rabbits-robotics/rabbits_description/README.md

# rabbits_description



機体の URDF（xacro）と rviz での表示 launch。`urdf/<機体>/` と `meshes/<機体>/` に機体ごとに置き、機体をまたいで使うもの（色の定義など）だけ `urdf/common/` に置く。

| 機体 | 最上位 | 内容 |
|---|---|---|
| proto1 | `urdf/proto1/proto1.xacro` | オムニ 4 輪 + 砲塔 Yaw / Pitch（メッシュあり） |
| gamma | `urdf/gamma/gamma.xacro` | 脚 4 本（4 節リンク、各脚の先に車輪）+ 首 Yaw / Pitch / Roll + カメラ。**脚は実寸**（`config/gamma_linkage.yaml`）、**首と胴体は仮**（箱と円筒）。メッシュは下の約束で書き出したら差し替える |

```bash
ros2 launch rabbits_description display.launch.py robot:=gamma use_gui:=true   # スライダで関節を動かして確認
ros2 launch rabbits_description display.launch.py robot:=gamma                # joint_states は外（robot_bridge など）から
```

```
urdf/
  common/materials.xacro     色の定義
  proto1/proto1.xacro        最上位 + 部品マクロ（mobile_base, wheel, turret_base, turret_unit）
  gamma/gamma.xacro          最上位 + 部品マクロ（body, leg, neck）
config/gamma_linkage.yaml    gamma の脚リンクと首の寸法（xacro とノードが読む。gamma_turret_fw の robot.hpp と対で更新）
include/rabbits_description/linkage_params.hpp  gamma_linkage.yaml を ROS パラメータから読むライブラリ（下の「ライブラリ」）
include/rabbits_description/footprint.hpp        4 輪の接地点と胴体の置き方（base_footprint → base_link）の計算（同上）
src/linkage_state_publisher.cpp  gamma の派生関節を足すミキサー（motor_joint_states → joint_states）
meshes/
  proto1/*.dae
  gamma/                     メッシュを書き出したら
rviz/display.rviz
```

## ライブラリ `rabbits_description::rabbits_description`

ミキサーのほか rabbits_sim（偽ファーム）と rabbits_gui（`imu_footprint_node`）が使う共通部分。yaml の読み方と接地点の計算を 1 か所にまとめる。

**`linkage_params.hpp`**: `config/gamma_linkage.yaml` の `linkage.*` を ROS パラメータから rabcl の設定構造体に読む関数。

| 関数 | 読むパラメータ | 返す型 |
|---|---|---|
| `LoadLegLinkage(node)` | `linkage.crank_length` 〜 `theta_max`（脚リンクの寸法） | `rabcl::LegLinkageConfig` |
| `LoadBodyPosture(node)` | 上 + `drop_min` / `drop_max` / `tilt_radius` / `leg_azimuth` | `rabcl::BodyPostureConfig` |
| `LoadFootprintParams(node)` | `leg_radius` / `wheel_radius` / `leg_azimuth` | `FootprintParams` |

すべて必須。足りない・型が違う・要素数が違うと `std::invalid_argument`（`what()` にパラメータ名）。未宣言なら `declare_parameter` し、宣言済みなら読むだけなので、同じノードで複数の `Load*` を呼べる。

**`footprint.hpp`**: 4 輪の接地点（base 座標）と、それを地面 z = 0 に乗せる `base_footprint → base_link` の回転と高さ。`ContactPointsOf(pose[4], FootprintParams)` が接地点（車輪中心の真下 `wheel_radius`）、`PlaneFootprint(c, quat, height)` が 4 輪が同じ平面に接地するとしたときの姿勢（対角線 2 本の外積で法線、4 点の平均で高さ。yaw なし）、`LowestWheelHeight(c, quat)` が与えた姿勢で最も低い接地点が地面に乗る高さ（IMU の姿勢と組み合わせて使う）。

使う側は `package.xml` に `<depend>rabbits_description</depend>`、CMake で `find_package(rabbits_description REQUIRED)` と `target_link_libraries(x rabbits_description::rabbits_description)`。

## gamma

- 関節名は [rabbits_bridge](https://github.com/rabbits-robotics/rabbits_bridge) の `config/gamma.yaml` の `joints`（関節番号順）と同じ: `yaw_joint`, `pitch_joint`, `roll_joint`, `right_front_wheel_joint`, `left_front_wheel_joint`, `right_back_wheel_joint`, `left_back_wheel_joint`, `right_front_leg_joint`, `left_front_leg_joint`, `right_back_leg_joint`, `left_back_leg_joint`。ファームの `JOINT_STATE` → bridge の `joint_states` がそのまま入る。
- 軸の向き（確定。設計書は rabbits_sim の `docs/superpowers/specs/2026-10-24-gamma-sim-design.md` 5 章）: 車輪は車輪リンクの z 軸が回転軸で z 正が機体の外側。脚は角度 0 が最下点（メカスト、原点）で、角度が増えると腕の先の車輪が下がり車体が上がる。首は yaw（z）→ pitch（y、−π/12〜π/6）→ roll（x、±π/6）→ `camera_link`（カメラ）→ `imu_link`（固定、BNO055。bridge の `imu/data` の `frame_id`）。符号は REP-103。
- `imu_link` の向きは `camera_link` と同じ（回転なし）。軸の入れ替えはファームが BNO055 のレジスタで済ませて `imu/data` をカメラ座標系で出すので、TF で二重に回さない。位置は仮（カメラの後ろ 0.03 m）。
- 脚は 4 節リンク（モータ軸 → クランク → 連結リンク → 車輪ホルダ、ホルダを平行に保つバー 2 本。記号と形は [docs/gamma_leg_linkage.svg](docs/gamma_leg_linkage.svg)、設計書は rabcl の `docs/superpowers/specs/2026-10-25-gamma-leg-linkage-design.md`）。URDF は木構造なのでループを連結リンクの先端で切り、各脚に `*_leg_joint`（モータ角、`joint_states`）、`*_bar_joint` と `*_coupler_joint`（派生）、`*_bar_lower_joint` と `*_holder_joint`（`mimic`）、`*_wheel_joint` を置く。派生関節は線形でないので `mimic` では表せず、**`linkage_state_publisher`（ミキサー）** が `motor_joint_states`（bridge / 偽ファームの出力をリマップしたもの）を受け、そのまま写したうえで派生 8 関節を rabcl `LegLinkage` で計算して足し、`joint_states` を 1 本で出す。`/joint_states` の発行元はこのノードだけ（1 トピック 1 発行元）。ミキサーが落ちると `robot_state_publisher` に何も届かない。入力に無い首関節（`fill_zero_joints`、既定 `yaw_joint` / `pitch_joint` / `roll_joint`）は 0 で埋めて出す。首のモータが未接続でも `imu_link` / `camera_link` までの TF の鎖が切れないようにするため。
- リンクのフレームは「z = その関節の回転軸、x = ゼロ姿勢でのリンクの長さ方向」（メッシュの座標系と同じ）。関節の値はゼロ姿勢からの変化分で、正 = 車体が上がる向き（ゼロ姿勢では全関節 0）。ミキサーが出す値は bar = −(φ − φ0)、coupler = −((ψ − α) − (ψ0 − α0))。
- base 原点は 4 本の脚モータ軸を含む水平面と Yaw 軸の交点（x 前、y 左、z 上）。首 Yaw 原点はその 25.5 mm 下、Pitch / Roll はそこから 126.4 mm 上の同じ点（仮）。
- pitch / roll は論理関節（ファームが差動リンクの 2 モータ角から求めた値）。ロール軸を後回しにする間は 0 が来て静止する。
- ミキサーは `base_footprint → base_link` の TF も出す（`publish_footprint`、既定 true）。4 輪の接地点（車輪中心の真下 `wheel_radius`。脚の方位角は yaml の `linkage.leg_azimuth`）が地面 z = 0 に乗るように、対角線 2 本の外積で地面の法線、4 点の平均で高さを決める。yaw は含めない（`base_footprint` の x は胴体の前を地面に投影した向き）。rviz の固定フレームは `base_footprint`（display.rviz / bringup の gamma.rviz）なので、車高を上げると胴体が上がり、ロール・ピッチで胴体が傾いて見える。オドメトリ（`map → base_footprint`）は無い。
- 車輪の回転の向きは、`joint_states` に入る角度（ファーム / 偽ファームの `OmniDrive × WHEEL_SIGN`）をそのまま表す。現状の `WHEEL_SIGN = -1` では前進指令で後ろに転がって見える（rabbits_sim の README「rviz での車輪の向きの読み方」）。

### gamma のメッシュの座標系（CAD で STL を書き出すときの約束）

STL はリンクごとに 1 ファイル（`meshes/gamma/<リンク>.stl`、バイナリ、mm、粗い解像度で 1 ファイル 1〜2 MB 以下）。**各 STL の原点と軸は、そのリンクの URDF フレームに一致させる**（xacro 側の visual origin を 0 にしておくため）。すべて右手系、ゼロ姿勢（脚はモータ原点 = 最下点、首はまっすぐ前）で書き出す。同じ形の脚と車輪は右前の 1 組だけ書き出し、4 本に使い回す。大きすぎる STL は Blender の Decimate（collapse）で減らす（胴体は 155k → 46k 三角形、比率 0.3 で見た目を保てた。`blender -b --python <script>` で `wm.stl_import` → Decimate → `wm.stl_export`、軸変換なし）。

| STL | 中身 | 原点 | 軸（= URDF のリンクフレーム） |
|---|---|---|---|
| `base.stl` | 胴体と胴体に固定の部品（脚モータの固定側、バーの胴体側ブラケットを含む） | base 原点（4 本の脚モータ軸を含む水平面と Yaw 軸の交点） | x 前、y 左、z 上 |
| `crank.stl` | 右前のクランク（脚モータの出力ディスクに付いて回る板） | 脚モータ軸 M 上、横方向は脚の中心面 | z = モータの回転軸（右ねじで回すと先端が下がる向き）、x = M → 先端ピン K の向き |
| `coupler.stl` | 右前の連結リンク（L 字） | クランク先端ピン K 上、横方向は脚の中心面 | z = ピンの軸（同じ向き）、x = K → ホルダ上端ピン J の向き |
| `bar.stl` | 右前の上側のバー、左右 2 本をまとめて 1 ファイル（下側も同じ形なら使い回す） | 胴体側ピン B1 上、横方向は脚の中心面 | z = ピンの軸（同じ向き）、x = B1 → H1 の向き |
| `holder.stl` | 右前の車輪ホルダ（車輪モータの固定側、ギア列、ピン類を含む） | 上のバーのホルダ側ピン H1 上、横方向は脚の中心面 | z = ピンの軸（同じ向き）、x = 水平で半径方向の外向き（y は下） |
| `wheel.stl` | 右前の車輪 1 個 | 車輪の中心 W | z = 回転軸で z 正が機体の外側、x = 上 |
| `neck_yaw.stl` | Yaw 軸で回る部品 | Yaw 軸上の 1 点（base 原点の 25.5 mm 下 = `yaw_origin_z`） | x 前、y 左、z 上 |
| `neck_pitch.stl` | Pitch 軸で回る部品（あれば） | Pitch / Roll 軸の交点（Yaw 原点の 126.4 mm 上） | 同上 |
| `neck_camera.stl` | Roll 軸より先（カメラ、gamma_turret 基板）（あれば） | 同じ点 | 同上 |

部品ごとの原点と軸の図: [docs/gamma_mesh_origins.svg](docs/gamma_mesh_origins.svg)。脚の部品は「z = 取り付け側の関節の回転軸、x = ゼロ姿勢での長さ方向」で、CAD の部品座標系をそのまま使える。z の向きは 4 つのピン軸で共通（脚の面の y_left。側面図で見ると紙面の奥）。原点の横方向（y_left 方向）は部品の厚みの中央ではなく**脚の中心面**（車輪の中心を通り、クランクとバーが動く面）に取る。部品が中心面から横にずれて付いているなら、そのずれが STL にそのまま写るのが正しい。同じ形の脚と車輪は右前の 1 組だけ書き出し、4 本に使い回す。

あわせて控える値（mm / deg、各リンクの原点からの相対）:

| 値 | 使う先 |
|---|---|
| 脚の取り付け半径 r（`base` 原点から脚の回転軸までの水平距離） | 脚の関節の位置、`BodyPosture` |
| 腕の長さ L（脚の軸からナックルの軸まで）と、ゼロ姿勢で腕が水平から下がっている角度 θ0、可動範囲（原点から何度上がるか） | ナックルの位置、関節の limit、`BodyPosture` の幾何 |
| 2 本目の腕の軸の位置（1 本目の軸からの xyz、`leg_arm` の向きで） | 平行四辺形 |
| 車輪の中心（ナックル原点からの xyz） | 車輪の関節 |
| Yaw 軸の原点の高さ（`base` 原点から）、Pitch 軸の原点（Yaw 原点から）、Roll 軸の原点（Pitch 原点から） | 首の関節 |
| カメラのレンズ中心と IMU（`neck_camera` 原点から） | `camera_link` / `imu_link` |
| 胴体の外形（当たり判定用の箱の寸法。無くてもよい） | collision |
