rabbits-robotics/rabbits_description/meshes/gamma/base.STL

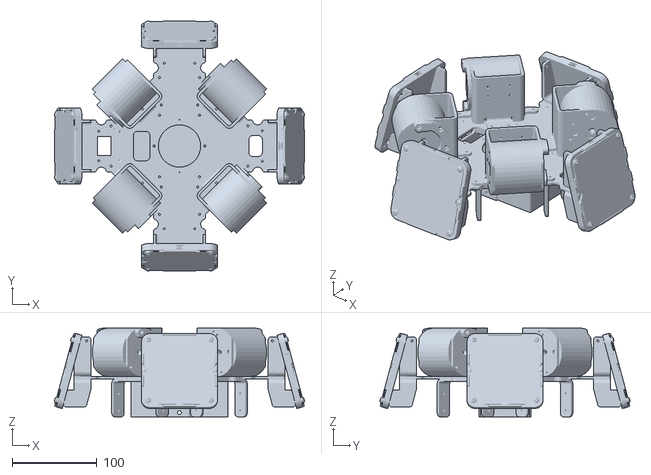
[picture p1: CAD file, 2026-10-25]
meshes/gamma/base.STL
295.8 x 295.8 x 105.0
