rabbits-robotics/rabbits_description/meshes/gamma/coupler.STL

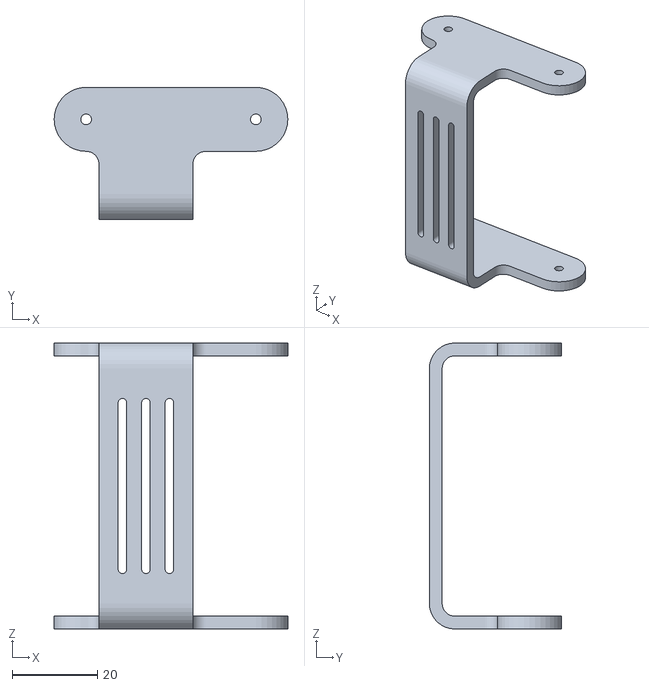
[picture p2: CAD file, 2026-10-25]
meshes/gamma/coupler.STL
54.8 x 31.0 x 67.0
