rabbits-robotics/rabbits_description/meshes/gamma/bar.STL

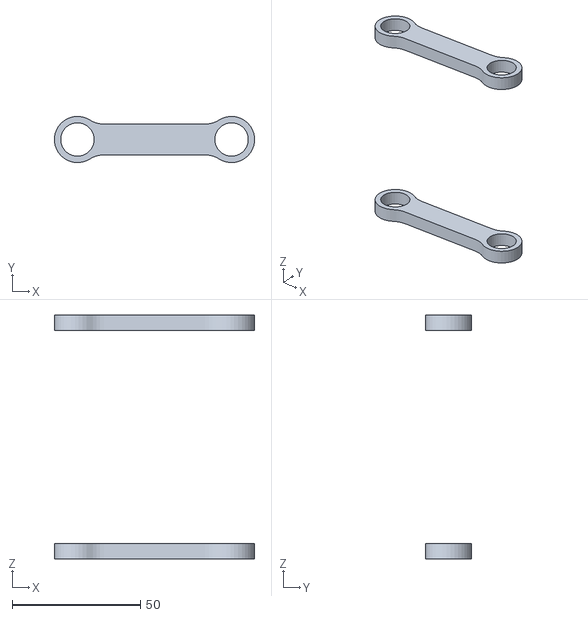
[picture p3: CAD file, 2026-10-25]
meshes/gamma/bar.STL
77.9 x 18.0 x 95.0
