rabbits-robotics/rabbits_description/meshes/gamma/wheel.STL

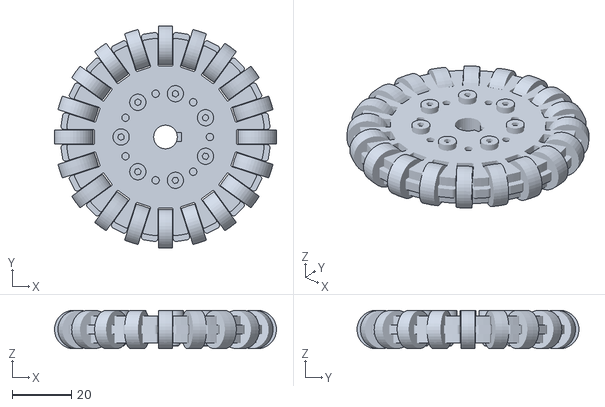
[picture p4: CAD file, 2026-10-25]
meshes/gamma/wheel.STL
75.0 x 75.0 x 13.0
