rabbits-robotics/rabbits_description/meshes/gamma/crank.STL

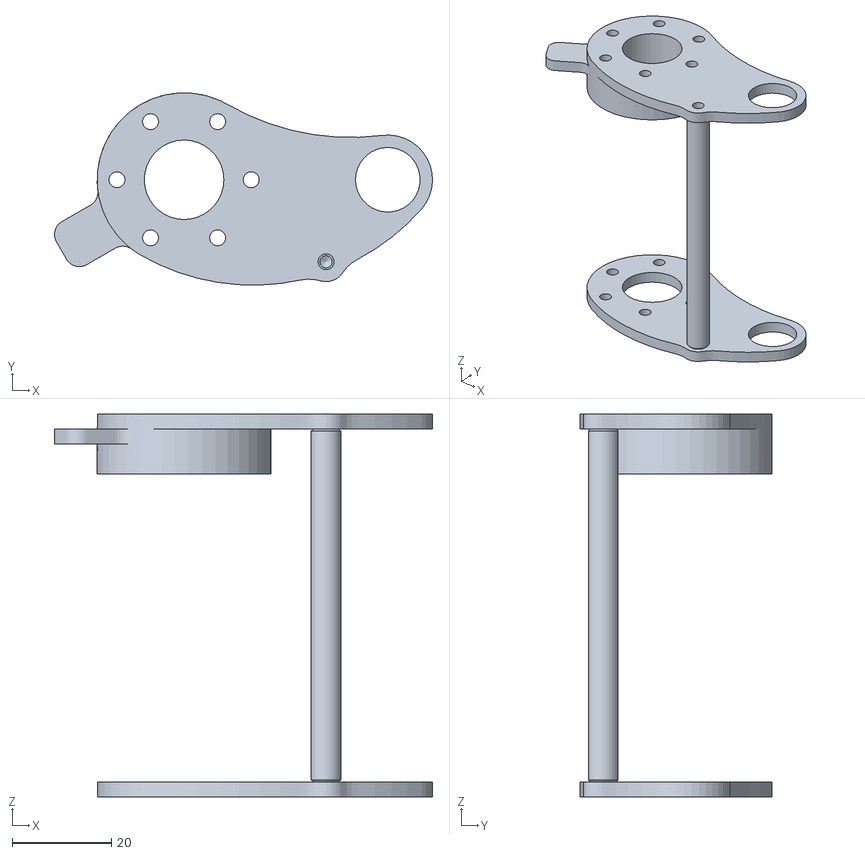
[picture p5: CAD file, 2026-10-25]
meshes/gamma/crank.STL
76.1 x 38.7 x 77.0
