rabbits-robotics/rabbits_description/meshes/gamma/holder.STL

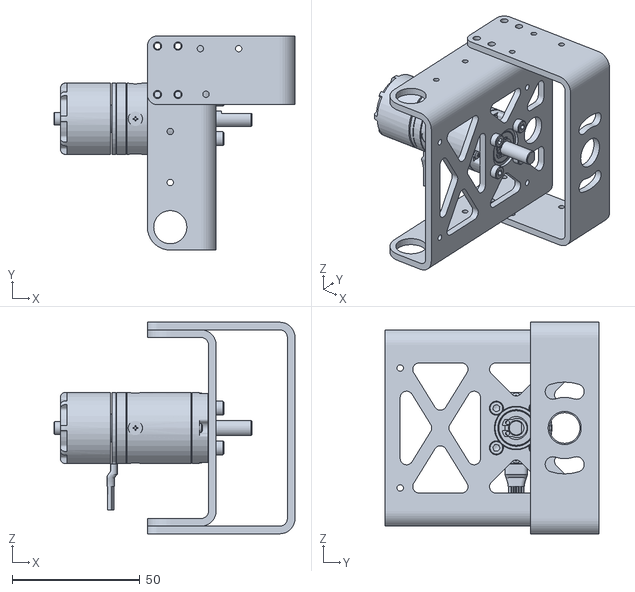
[picture p6: CAD file, 2026-10-25]
meshes/gamma/holder.STL
94.5 x 84.0 x 83.0
