rabbits-robotics/rabbits_description/urdf/gamma/leg.xacro

<?xml version="1.0"?>
<!--
  gamma の脚 1 本 + 車輪（4 節リンク、実寸。設計書 rabcl docs/superpowers/specs/2026-10-25-gamma-leg-linkage-design.md 7 章）。
  寸法は config/gamma_linkage.yaml（引数 L）。見た目は meshes/gamma/*.STL（mm、リンクのフレームそのもの。原点と軸の約束は README）。

  リンクのフレーム（メッシュの座標系と一致させる）: 各リンクは「z = その関節の回転軸、x = ゼロ姿勢でのリンクの長さ方向」。
    脚の面（x 外向き、z_up 上、y_left = z_up × x）で、回転軸 = y_left。z 軸は右ねじで回すとリンクの先が下がる向き。
    胴体に付く関節の origin は rpy = (−π/2, −a, azimuth)（a = ゼロ姿勢でのリンクの向き、+x から上向き正）。
    base_link
     ├─ <p>_leg_joint   （M、x はクランクの向き α0。値 θ = joint_states の脚モータ角、0 = 車高が最も低い）→ crank_link
     │    └─ <p>_coupler_joint（K、x は連結リンクの向き。派生: ゼロ姿勢からの変化分）→ coupler_link（先端 J は閉じない）
     ├─ <p>_bar_joint   （B1、x はバーの向き φ0。派生: ゼロ姿勢からの変化分）→ bar_link（上のバー）
     │    └─ <p>_holder_joint（H1、x は水平外向き。mimic bar × −1）→ holder_link（車輪ホルダ。胴体と平行を保つ）
     │         └─ <p>_wheel_joint（W、z = 回転軸 = 半径方向の外向き、x 上）→ wheel
     └─ <p>_bar_lower_joint（B2、mimic bar × 1）→ bar_lower_link（下のバー）
  派生関節（bar、coupler）は linkage_state_publisher が rabcl::LegLinkage で計算し、ゼロ姿勢の角度を引いて joint_states に足す
  （ゼロ姿勢では全関節が 0）。正の回転はどれも「車体が上がる向き」。
-->
<robot xmlns:xacro="http://ros.org/wiki/xacro">
  <xacro:macro name="gamma_leg" params="prefix azimuth L">
    <xacro:property name="a0" value="${L['crank_angle_zero']}" />
    <xacro:property name="phi0" value="${L['bar_angle_zero']}" />
    <xacro:property name="psi0" value="${L['coupler_dir_zero']}" />
    <xacro:property name="Lc" value="${L['crank_length']}" />
    <xacro:property name="Lr" value="${L['coupler_length']}" />
    <xacro:property name="Lb" value="${L['bar_length']}" />
    <xacro:property name="r" value="${L['leg_radius']}" />

    <!-- クランク（脚モータの出力）: 原点 M、x = クランクの向き -->
    <joint name="${prefix}_leg_joint" type="revolute">
      <parent link="base_link" />
      <child link="${prefix}_crank_link" />
      <origin xyz="${r * cos(azimuth)} ${r * sin(azimuth)} 0" rpy="${-pi / 2} ${-a0} ${azimuth}" />
      <axis xyz="0 0 1" />
      <limit lower="0" upper="${L['theta_max']}" effort="10" velocity="5" />
    </joint>
    <link name="${prefix}_crank_link">
      <!-- メッシュはリンクのフレームそのもの（README「gamma のメッシュの座標系」）。mm なので 0.001 -->
      <visual>
        <origin xyz="0 0 0" rpy="0 0 0" />
        <geometry>
          <mesh filename="package://rabbits_description/meshes/gamma/crank.STL" scale="0.001 0.001 0.001" />
        </geometry>
        <material name="rabbits_pale_blue" />
      </visual>
    </link>

    <!-- 連結リンク: 原点 K（クランクの先）、x = 連結リンクの向き。クランクから ψ0 − α0 だけ回った所がゼロ姿勢 -->
    <joint name="${prefix}_coupler_joint" type="revolute">
      <parent link="${prefix}_crank_link" />
      <child link="${prefix}_coupler_link" />
      <origin xyz="${Lc} 0 0" rpy="0 0 ${a0 - psi0}" />
      <axis xyz="0 0 1" />
      <limit lower="${-pi}" upper="${pi}" effort="0" velocity="10" />
    </joint>
    <link name="${prefix}_coupler_link">
      <visual>
        <origin xyz="0 0 0" rpy="0 0 0" />
        <geometry>
          <mesh filename="package://rabbits_description/meshes/gamma/coupler.STL" scale="0.001 0.001 0.001" />
        </geometry>
        <material name="rabbits_pale_orange" />
      </visual>
    </link>

    <!-- 上のバー: 原点 B1、x = バーの向き φ0 -->
    <joint name="${prefix}_bar_joint" type="revolute">
      <parent link="base_link" />
      <child link="${prefix}_bar_link" />
      <origin xyz="${(r + L['bar_pivot'][0]) * cos(azimuth)} ${(r + L['bar_pivot'][0]) * sin(azimuth)} ${L['bar_pivot'][1]}" rpy="${-pi / 2} ${-phi0} ${azimuth}" />
      <axis xyz="0 0 1" />
      <limit lower="${-pi}" upper="${pi}" effort="0" velocity="10" />
    </joint>
    <link name="${prefix}_bar_link">
      <visual>
        <origin xyz="0 0 0" rpy="0 0 0" />
        <geometry>
          <mesh filename="package://rabbits_description/meshes/gamma/bar.STL" scale="0.001 0.001 0.001" />
        </geometry>
        <material name="rabbits_pale_green" />
      </visual>
    </link>

    <!-- 下のバー: 原点 B2、上のバーと同じ角度 -->
    <joint name="${prefix}_bar_lower_joint" type="revolute">
      <parent link="base_link" />
      <child link="${prefix}_bar_lower_link" />
      <origin xyz="${(r + L['bar_pivot_lower'][0]) * cos(azimuth)} ${(r + L['bar_pivot_lower'][0]) * sin(azimuth)} ${L['bar_pivot_lower'][1]}" rpy="${-pi / 2} ${-phi0} ${azimuth}" />
      <axis xyz="0 0 1" />
      <limit lower="${-pi}" upper="${pi}" effort="0" velocity="10" />
      <mimic joint="${prefix}_bar_joint" multiplier="1" offset="0" />
    </joint>
    <link name="${prefix}_bar_lower_link">
      <visual>
        <origin xyz="0 0 0" rpy="0 0 0" />
        <geometry>
          <mesh filename="package://rabbits_description/meshes/gamma/bar.STL" scale="0.001 0.001 0.001" />
        </geometry>
        <material name="rabbits_pale_green" />
      </visual>
    </link>

    <!-- ホルダ: 原点 H1（上のバーの先）、x = 水平外向き、y = 下。バーと逆に回って胴体と平行を保つ -->
    <joint name="${prefix}_holder_joint" type="revolute">
      <parent link="${prefix}_bar_link" />
      <child link="${prefix}_holder_link" />
      <origin xyz="${Lb} 0 0" rpy="0 0 ${phi0}" />
      <axis xyz="0 0 1" />
      <limit lower="${-pi}" upper="${pi}" effort="0" velocity="10" />
      <mimic joint="${prefix}_bar_joint" multiplier="-1" offset="0" />
    </joint>
    <link name="${prefix}_holder_link">
      <!-- J（上端ピン）は y = −coupler_pin.z、H2 は y = +0.02、W は (wheel.x, −wheel.z)（y は下向き正） -->
      <visual>
        <origin xyz="0 0 0" rpy="0 0 0" />
        <geometry>
          <mesh filename="package://rabbits_description/meshes/gamma/holder.STL" scale="0.001 0.001 0.001" />
        </geometry>
        <material name="rabbits_pale_purple" />
      </visual>
    </link>

    <!-- 車輪: 原点 W、z = 回転軸（半径方向の外向き）、x = 上 -->
    <joint name="${prefix}_wheel_joint" type="continuous">
      <parent link="${prefix}_holder_link" />
      <child link="${prefix}_wheel" />
      <origin xyz="${L['wheel'][0]} ${-L['wheel'][1]} 0" rpy="${-pi / 2} 0 ${-pi / 2}" />
      <axis xyz="0 0 1" />
    </joint>
    <link name="${prefix}_wheel">
      <visual>
        <origin xyz="0 0 0" rpy="0 0 0" />
        <geometry>
          <mesh filename="package://rabbits_description/meshes/gamma/wheel.STL" scale="0.001 0.001 0.001" />
        </geometry>
        <material name="rabbits_mid_grey" />
      </visual>
    </link>
  </xacro:macro>
</robot>
