rabbits-robotics/rabbits_description/(commit log)

2026-10-18 LICENSE を追加し package.xml のライセンスを MIT に設定
2026-10-18 attracts_description を rabbits_description に rename
2026-10-24 gamma の URDF を追加（寸法は仮）
2026-10-24 README に車輪の向きの注記を追加
2026-10-24 gamma の URDF に imu_link を追加
2026-10-25 胴体に正面の目印を付ける
2026-10-25 gamma の脚を 4 節リンクの実寸にし、派生関節を出すミキサーを追加
2026-10-25 CI で rabcl を取り込み、display の GUI を機体で出し分ける
2026-10-25 脚リンクのフレームをメッシュの座標系に合わせ、脚のメッシュを入れる
2026-10-25 胴体のメッシュを入れる
2026-10-25 胴体のメッシュを圧縮する
2026-10-25 メッシュの圧縮の手順を README に書く
2026-10-25 リンクを種類ごとに淡い色で分ける
2026-10-25 base_footprint の TF を出して胴体の傾きを rviz で見せる
2026-11-02 gamma_linkage.yaml の読み込みをライブラリにし、脚の方位角を yaml に移す
2026-11-02 接地点と胴体の置き方の計算をライブラリに切り出す
2026-11-04 ミキサーが無い首関節を 0 で埋めて TF の鎖を保つ
2026-11-04 宣言済みの型違いが名前付き例外になることをテストで固定する
